AU-Eco-Shell-Marathon/MotorController/(list of files, drawings)

Other design files:
hardware/MotorControllerUnit/Horn + CAN.ms13
hardware/MotorControllerUnit/MotorControllerUnit.ms13
hardware/MotorControllerUnit/Step down converter.ms13
hardware/SD-card/AU2 - Interface to SD-card.ms13
hardware/Speedometer/Speedometer.ms13
