AU-Eco-Shell-Marathon/MotorController/src/MotorController.cydsn/LUT_data.h

#include <project.h>
#define LUT_SIZE 83
#define LUT_LSB 4
#define LUT_SHIFT 2

static const uint8 RAMP_LUT[LUT_SIZE] = {
0, 3, 6, 9, 12, 14, 17, 19, 21, 24, 26, 29, 31, 34, 36, 39, 41, 44, 46, 49, 51, 53, 56, 58, 61, 63, 66, 68, 71, 79, 87, 96, 104, 112, 121, 129, 137, 146, 154, 162, 171, 179, 185, 192, 199, 205, 212, 219, 225, 232, 239, 245, 252, 255, 255, 255, 255, 255, 255, 255, 255, 255, 255, 255, 255, 255, 255, 255, 255, 255, 255, 255, 255, 255, 255, 255, 255, 255, 255, 255, 255, 255, 255
};

static const uint8 CONST_LUT[LUT_SIZE] = {
0, 1, 2, 3, 4, 6, 7, 8, 9, 10, 11, 12, 15, 17, 20, 23, 25, 28, 30, 33, 36, 38, 41, 44, 46, 49, 52, 54, 57, 60, 62, 65, 68, 70, 73, 75, 78, 81, 83, 86, 89, 91, 94, 97, 99, 102, 105, 108, 111, 114, 117, 120, 123, 126, 129, 133, 136, 139, 142, 145, 148, 152, 155, 159, 162, 166, 170, 173, 177, 181, 184, 0, 0, 0, 0, 0, 0, 0, 0, 0, 0, 0, 0
};
