AU-Eco-Shell-Marathon/MotorController/src/MotorController.cydsn/AU2const.h

#ifndef AU2CONST_H
#define AU2CONST_H
    
    #define PI 3.141593f
    #define mPI 3146u
    #define AU_WHEEL_RADIUS_MM 239u 
    #define OPTIMAL_SPEED_RPM 275u
    #define THRESHOLD_RPM 57u
        
#endif
