AU-Eco-Shell-Marathon/MotorController/(commit log)

2016-05-11 MCU new
    [MotorController.sdf]
2016-05-12 Fixed folder structure
    [MotorController.sdf]
2016-05-12 Fixed missing lib file + changer folder structure a bit
    [CAN.c, CAN.h, Logger.c, main.c]
2016-09-18 clean up
    [AU2 - Interface to SD-card.ms13, Horn + CAN.ms13, MotorControllerUnit.ms13, Speedometer.ms13, Step down converter.ms13]
